najgos/micro-drone/dr3/dr3.kicad_pcb

## KiCad design dr3/dr3.kicad_pcb (2026-11-06)

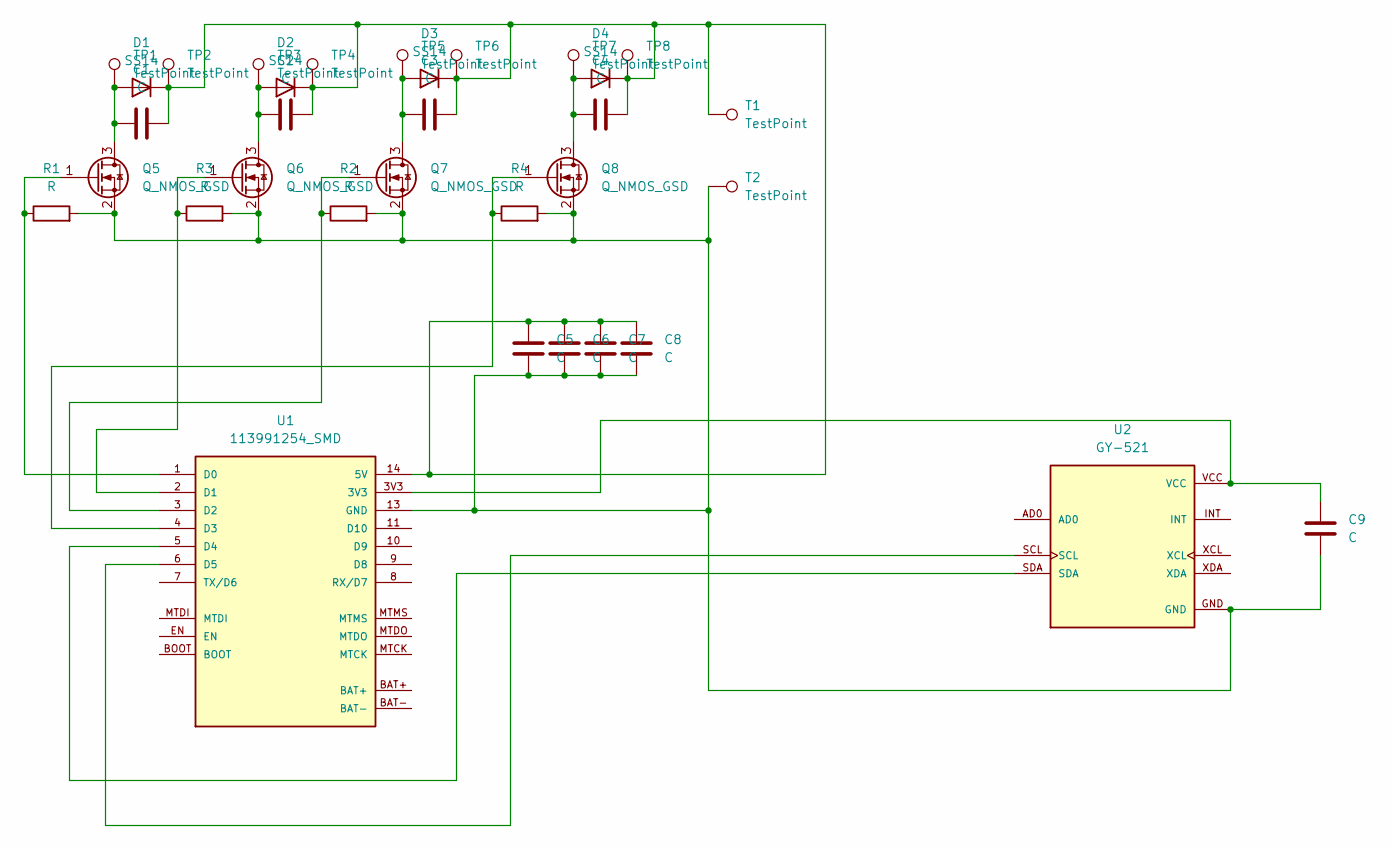
[picture p5: schematic dr3.kicad_sch]

Parts:
C1, C2, C3, C4, C5, C6, C7, C8, C9: C; C_0805_2012Metric_Pad1.18x1.45mm_HandSolder
D1, D2, D3, D4: SS14; D_SMA_Handsoldering
Q5, Q6, Q7, Q8: Q_NMOS_GSD; SOT-23_Handsoldering
R1, R2, R3, R4: R; R_0805_2012Metric_Pad1.20x1.40mm_HandSolder
T1, T2: TestPoint; TestPoint_THTPad_2.0x2.0mm_Drill1.0mm
TP1, TP2, TP3, TP4, TP5, TP6, TP7, TP8: TestPoint; TestPoint_THTPad_2.0x2.0mm_Drill1.0mm
U1: 113991254_SMD; esp32-c6; PARTREV 1.0
U2: GY-521; MODULE_GY-521; PARTREV NA

Connections:
3V3: C9.1, U1.3V3, U1.12 (3V3), U2.VCC
GND: C5.2, C6.2, C7.2, C8.2, C9.2, Q5.2 (S), Q6.2 (S), Q7.2 (S), Q8.2 (S), R1.2, R2.2, R3.2, R4.2, T2.1 (1_1), U1.13 (GND), U1.GND, U2.GND
unnamed: C1.1, D1.2 (A), Q5.3 (D), TP1.1 (1_1)
unnamed: C1.2, C2.2, C3.2, C4.2, C5.1, C6.1, C7.1, C8.1, D1.1 (K), D2.1 (K), D3.1 (K), D4.1 (K), T1.1 (1_1), TP2.1 (1_1), TP4.1 (1_1), TP6.1 (1_1), TP8.1 (1_1), U1.14 (5V)
unnamed: C2.1, D2.2 (A), Q6.3 (D), TP3.1 (1_1)
unnamed: C3.1, D3.2 (A), Q7.3 (D), TP5.1 (1_1)
unnamed: C4.1, D4.2 (A), Q8.3 (D), TP7.1 (1_1)
unnamed: Q5.1 (G), R1.1, U1.1 (D0)
unnamed: Q6.1 (G), R3.1, U1.2 (D1)
unnamed: Q7.1 (G), R2.1, U1.3 (D2)
unnamed: Q8.1 (G), R4.1, U1.4 (D3)
unnamed: U1.5 (D4), U2.SDA
unnamed: U1.6 (D5), U2.SCL

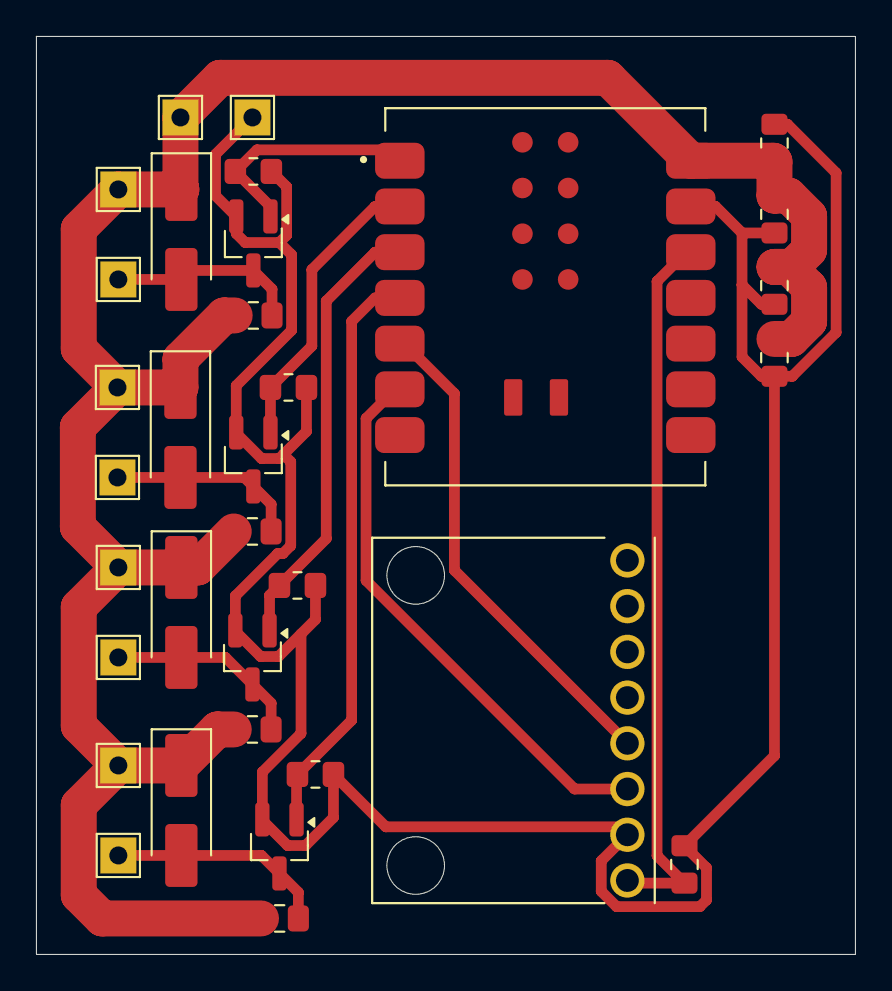
[picture p6: board dr3.kicad_pcb from above]

Board: 2 copper layers, 45.5 x 51.0 mm, 33 parts (0 on the bottom side), 13 nets.
