najgos/micro-drone/(commit log)

2026-11-03 DR3 micro drone: custom flight controller PCB and firmware
    [dr3-B_Cu.gbr, dr3-B_Mask.gbr, dr3-B_Paste.gbr, dr3-B_Silkscreen.gbr, dr3-Edge_Cuts.gbr, dr3-F_Cu.gbr, dr3-F_Mask.gbr, dr3-F_Paste.gbr]
2026-11-06 Keep only build and KiCad entries in .gitignore
2026-11-06 Set flyback diode value to SS14 in schematic and PCB
    [dr3.kicad_pcb, dr3.kicad_sch]
2026-11-06 README: name the SS14 diode on the motor channels
2026-11-06 Firmware: move the antenna pins to config.h and tidy comments
